jPleyte/microcontroller-turret/(commit log)

2020-07-23 Add manual button and update documentation
2020-07-23 Update the Arduino Pin Chart
2020-07-26 Add ammo counter and attached motion sensor. Deployed night 0.
2020-08-06 Add status LEDs and update doc to help recognise low battery issue
    [MotionSensingTurret_0.ino]
2021-05-31 Add annotation to relay image
